felix1024/SpeakerProtect/docs/Speaker Protect V1.0-Schema.pdf

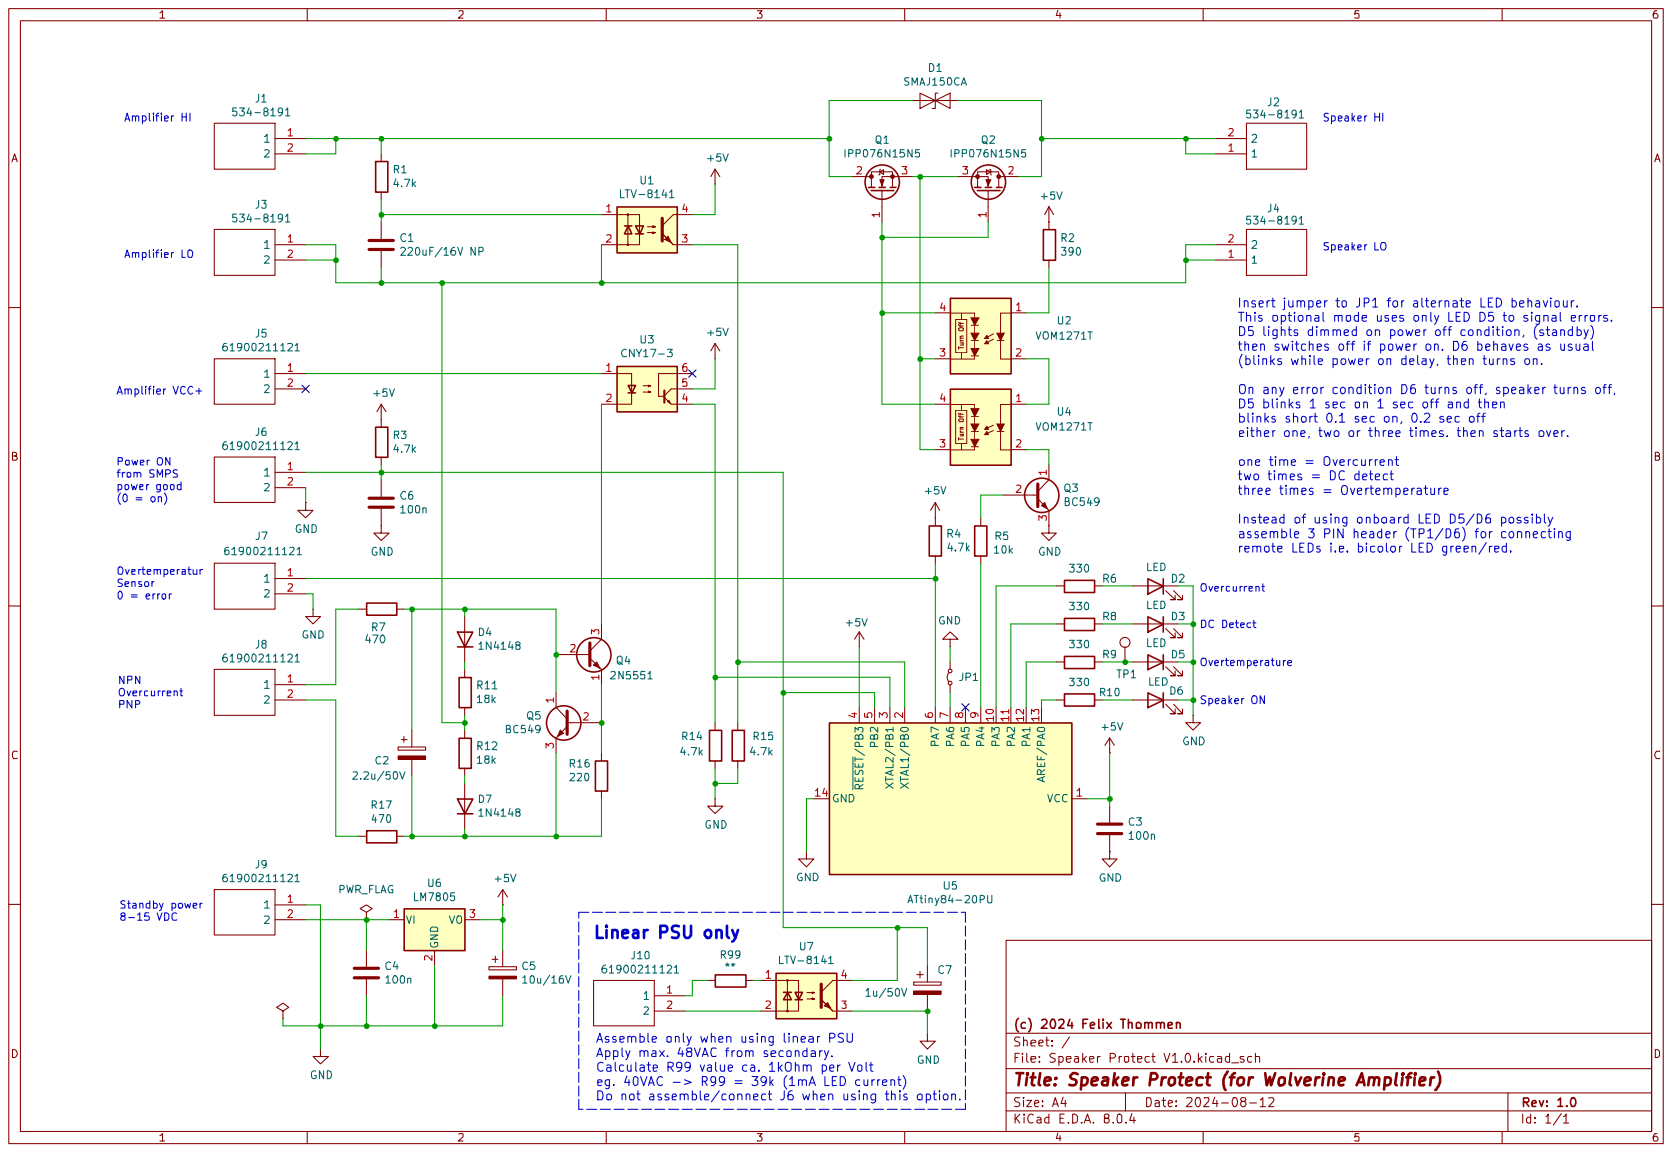
[picture p1: page 1]
