felix1024/SpeakerProtect/docs/Speaker Protect-V1.0-Layout.pdf

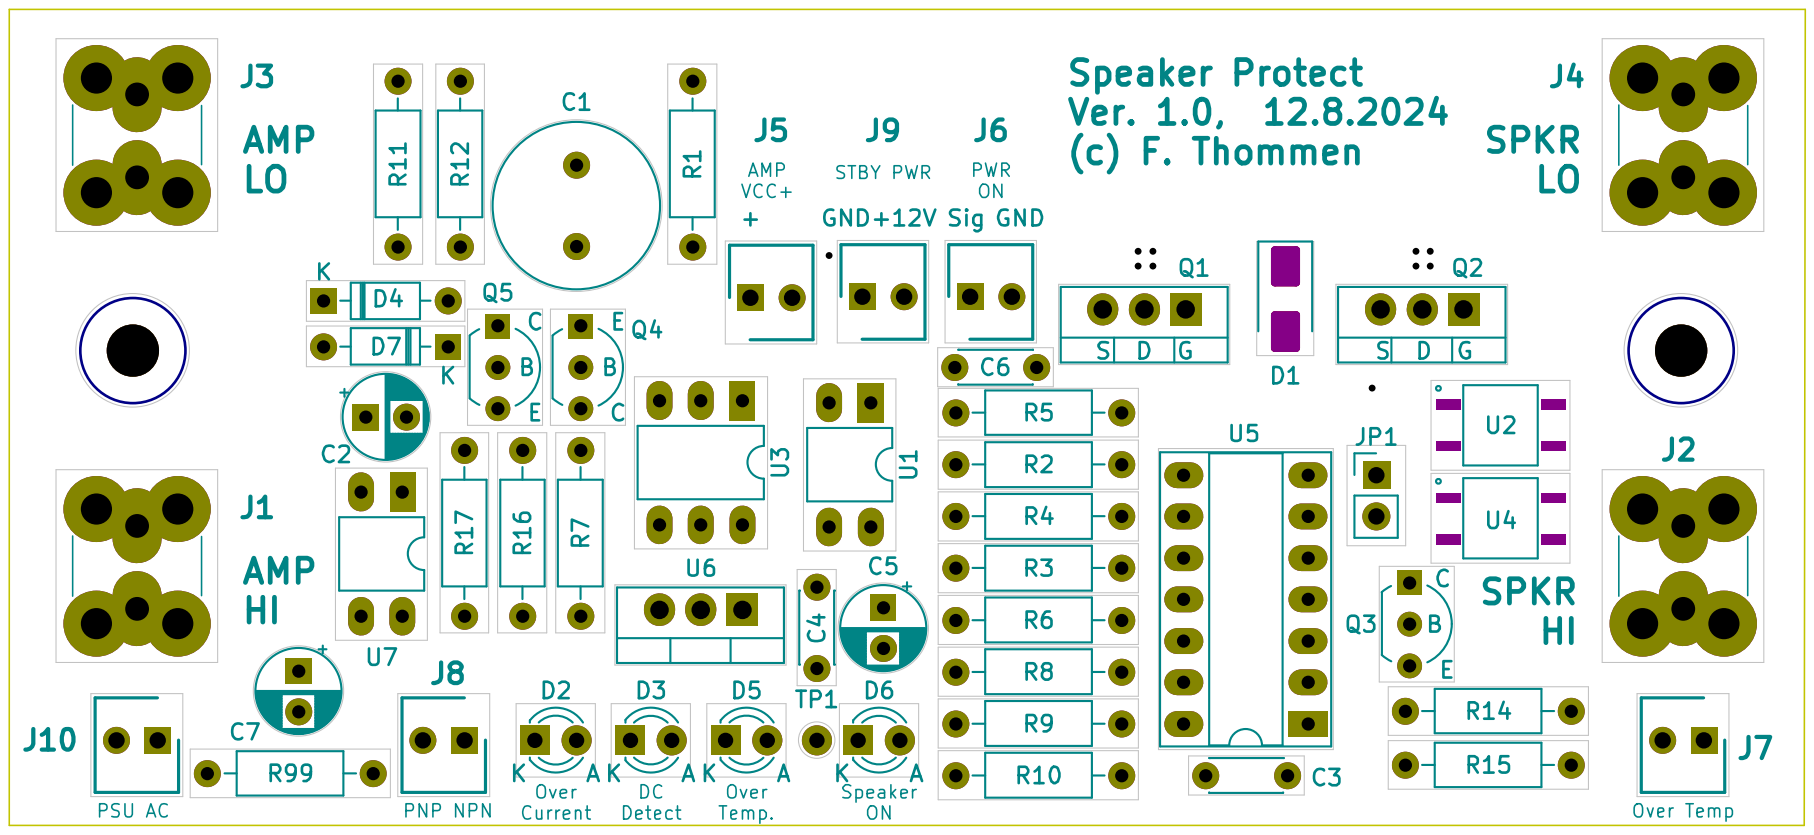
[picture p2: page 1]
