felix1024/SpeakerProtect/docs/Speaker Protect Interface.pdf

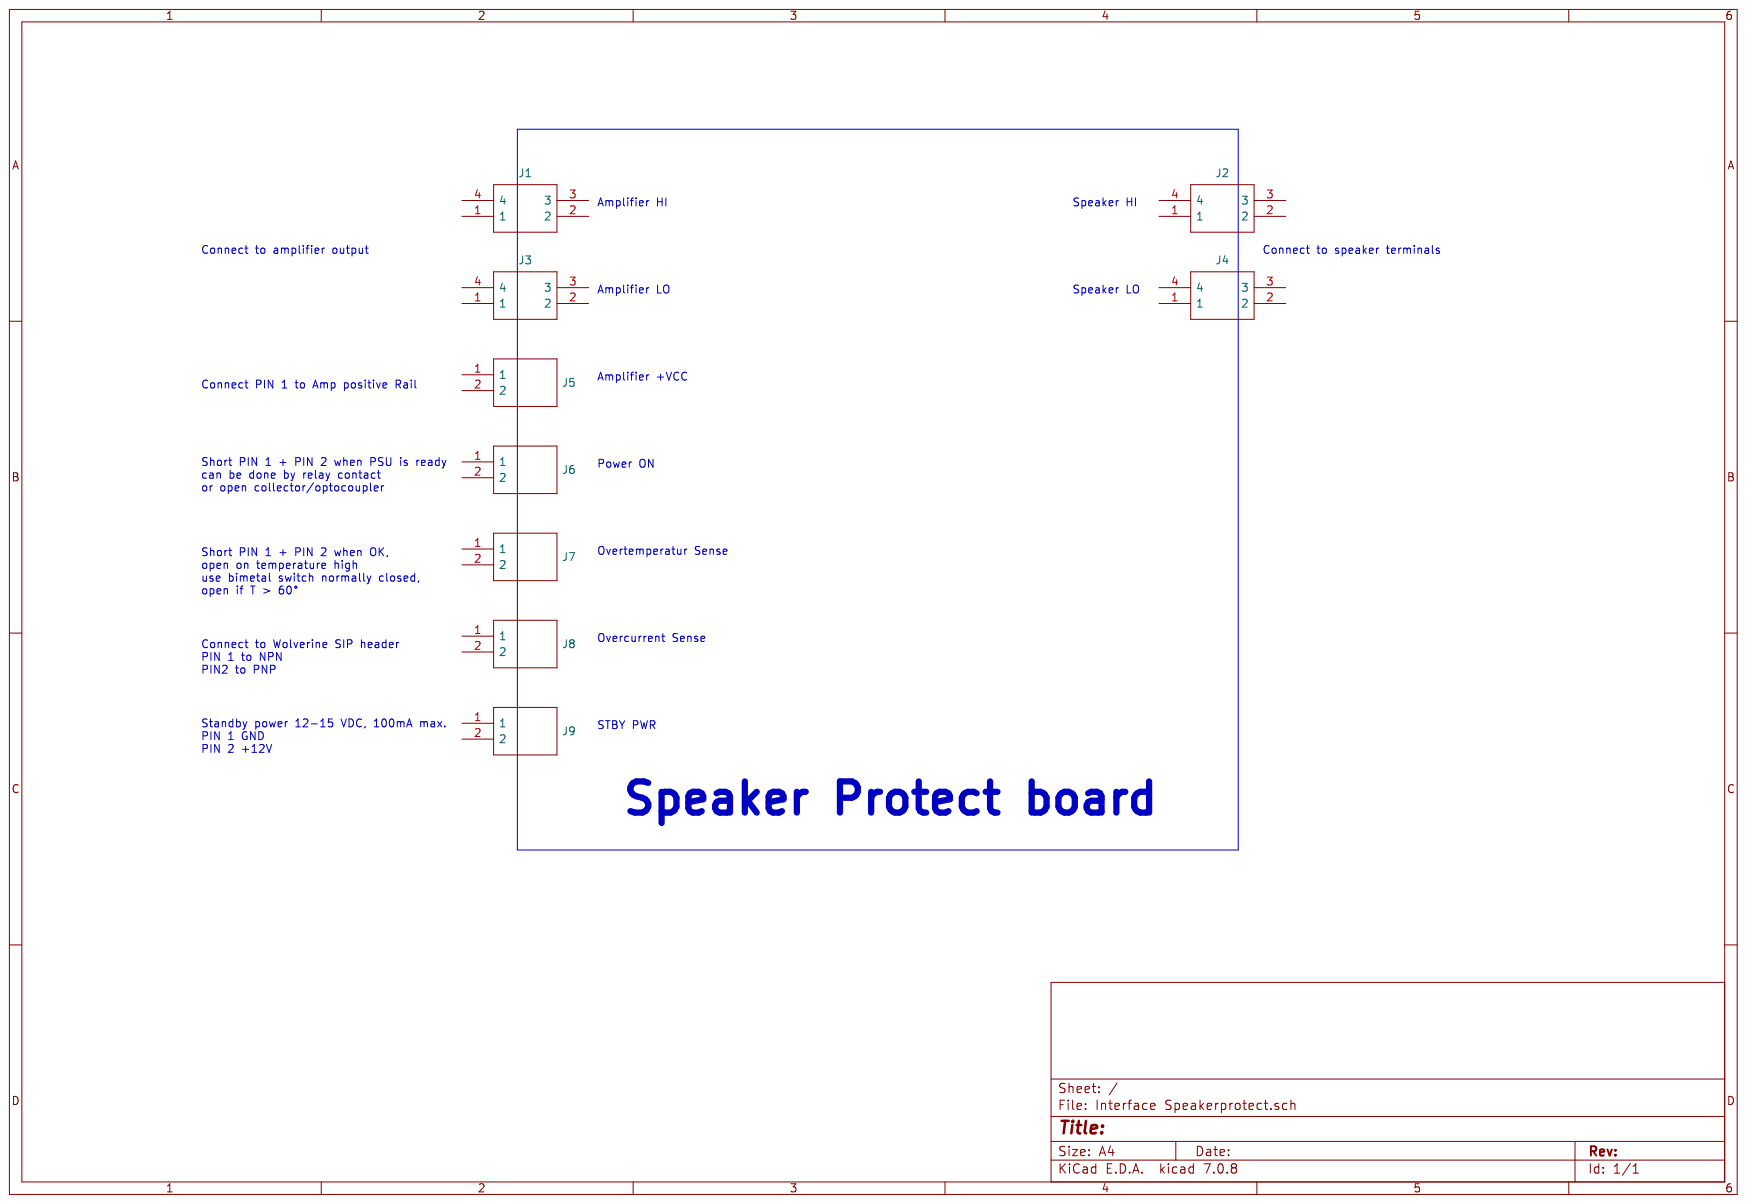
[picture p3: page 1]
